tukacustoms/Released-Files-TCBK40/PERMALINK LAYOUT.txt

http://www.keyboard-layout-editor.com/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

http://builder.swillkb.com/
