tukacustoms/Released-Files-TCBK40/BOM Files TCBK40 - BOM Files TCBK40.csv.csv

Source: | D:\Tuka-Customs-Keyboards\TCBK40\Custom new keyb.kicad_sch
Date: | 7/11/2024 19:20:24
Tool: | Eeschema (6.0.6)
Generator: | E:\Ki Cad PCB\6.0\bin\scripting\plugins/bom_csv_grouped_by_value.py
Component Count: | 122
Individual Components:
Item | Qty | Reference(s) | Value | LibPart | Footprint | Datasheet
 |  | D1 | 1N4148 | Diode:1N4148 | Diode_THT:D_DO-35_SOD27_P7.62mm_Horizontal | https://assets.nexperia.com/documents/data-sheet/1N4148_1N4448.pdf
 |  | D2 | 1N4148 | Diode:1N4148 | Diode_THT:D_DO-35_SOD27_P7.62mm_Horizontal | https://assets.nexperia.com/documents/data-sheet/1N4148_1N4448.pdf
 |  | D3 | 1N4148 | Diode:1N4148 | Diode_THT:D_DO-35_SOD27_P7.62mm_Horizontal | https://assets.nexperia.com/documents/data-sheet/1N4148_1N4448.pdf
 |  | D4 | 1N4148 | Diode:1N4148 | Diode_THT:D_DO-35_SOD27_P7.62mm_Horizontal | https://assets.nexperia.com/documents/data-sheet/1N4148_1N4448.pdf
 |  | D5 | 1N4148 | Diode:1N4148 | Diode_THT:D_DO-35_SOD27_P7.62mm_Horizontal | https://assets.nexperia.com/documents/data-sheet/1N4148_1N4448.pdf
 |  | D6 | 1N4148 | Diode:1N4148 | Diode_THT:D_DO-35_SOD27_P7.62mm_Horizontal | https://assets.nexperia.com/documents/data-sheet/1N4148_1N4448.pdf
 |  | D7 | 1N4148 | Diode:1N4148 | Diode_THT:D_DO-35_SOD27_P7.62mm_Horizontal | https://assets.nexperia.com/documents/data-sheet/1N4148_1N4448.pdf
 |  | D8 | 1N4148 | Diode:1N4148 | Diode_THT:D_DO-35_SOD27_P7.62mm_Horizontal | https://assets.nexperia.com/documents/data-sheet/1N4148_1N4448.pdf
 |  | D9 | 1N4148 | Diode:1N4148 | Diode_THT:D_DO-35_SOD27_P7.62mm_Horizontal | https://assets.nexperia.com/documents/data-sheet/1N4148_1N4448.pdf
 |  | D10 | 1N4148 | Diode:1N4148 | Diode_THT:D_DO-35_SOD27_P7.62mm_Horizontal | https://assets.nexperia.com/documents/data-sheet/1N4148_1N4448.pdf
 |  | D11 | 1N4148 | Diode:1N4148 | Diode_THT:D_DO-35_SOD27_P7.62mm_Horizontal | https://assets.nexperia.com/documents/data-sheet/1N4148_1N4448.pdf
 |  | D12 | 1N4148 | Diode:1N4148 | Diode_THT:D_DO-35_SOD27_P7.62mm_Horizontal | https://assets.nexperia.com/documents/data-sheet/1N4148_1N4448.pdf
 |  | D13 | 1N4148 | Diode:1N4148 | Diode_THT:D_DO-35_SOD27_P7.62mm_Horizontal | https://assets.nexperia.com/documents/data-sheet/1N4148_1N4448.pdf
 |  | D14 | 1N4148 | Diode:1N4148 | Diode_THT:D_DO-35_SOD27_P7.62mm_Horizontal | https://assets.nexperia.com/documents/data-sheet/1N4148_1N4448.pdf
 |  | D15 | 1N4148 | Diode:1N4148 | Diode_THT:D_DO-35_SOD27_P7.62mm_Horizontal | https://assets.nexperia.com/documents/data-sheet/1N4148_1N4448.pdf
 |  | D16 | 1N4148 | Diode:1N4148 | Diode_THT:D_DO-35_SOD27_P7.62mm_Horizontal | https://assets.nexperia.com/documents/data-sheet/1N4148_1N4448.pdf
 |  | D17 | 1N4148 | Diode:1N4148 | Diode_THT:D_DO-35_SOD27_P7.62mm_Horizontal | https://assets.nexperia.com/documents/data-sheet/1N4148_1N4448.pdf
 |  | D18 | 1N4148 | Diode:1N4148 | Diode_THT:D_DO-35_SOD27_P7.62mm_Horizontal | https://assets.nexperia.com/documents/data-sheet/1N4148_1N4448.pdf
 |  | D19 | 1N4148 | Diode:1N4148 | Diode_THT:D_DO-35_SOD27_P7.62mm_Horizontal | https://assets.nexperia.com/documents/data-sheet/1N4148_1N4448.pdf
 |  | D20 | 1N4148 | Diode:1N4148 | Diode_THT:D_DO-35_SOD27_P7.62mm_Horizontal | https://assets.nexperia.com/documents/data-sheet/1N4148_1N4448.pdf
 |  | D21 | 1N4148 | Diode:1N4148 | Diode_THT:D_DO-35_SOD27_P7.62mm_Horizontal | https://assets.nexperia.com/documents/data-sheet/1N4148_1N4448.pdf
 |  | D22 | 1N4148 | Diode:1N4148 | Diode_THT:D_DO-35_SOD27_P7.62mm_Horizontal | https://assets.nexperia.com/documents/data-sheet/1N4148_1N4448.pdf
 |  | D23 | 1N4148 | Diode:1N4148 | Diode_THT:D_DO-35_SOD27_P7.62mm_Horizontal | https://assets.nexperia.com/documents/data-sheet/1N4148_1N4448.pdf
 |  | D24 | 1N4148 | Diode:1N4148 | Diode_THT:D_DO-35_SOD27_P7.62mm_Horizontal | https://assets.nexperia.com/documents/data-sheet/1N4148_1N4448.pdf
 |  | D25 | 1N4148 | Diode:1N4148 | Diode_THT:D_DO-35_SOD27_P7.62mm_Horizontal | https://assets.nexperia.com/documents/data-sheet/1N4148_1N4448.pdf
 |  | D26 | 1N4148 | Diode:1N4148 | Diode_THT:D_DO-35_SOD27_P7.62mm_Horizontal | https://assets.nexperia.com/documents/data-sheet/1N4148_1N4448.pdf
 |  | D27 | 1N4148 | Diode:1N4148 | Diode_THT:D_DO-35_SOD27_P7.62mm_Horizontal | https://assets.nexperia.com/documents/data-sheet/1N4148_1N4448.pdf
 |  | D28 | 1N4148 | Diode:1N4148 | Diode_THT:D_DO-35_SOD27_P7.62mm_Horizontal | https://assets.nexperia.com/documents/data-sheet/1N4148_1N4448.pdf
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
 |  | SW3_2 | 1.00u | kobuss:1.00u | kobussfootprints:MX_1u | ~
 |  | SW3_3 | 1.00u | kobuss:1.00u | kobussfootprints:MX_1u | ~
 |  | SW3_4 | 1.00u | kobuss:1.00u | kobussfootprints:MX_1u | ~
 |  | SW3_5 | 1.00u | kobuss:1.00u | kobussfootprints:MX_1u | ~
 |  | SW3_6 | 1.00u | kobuss:1.00u | kobussfootprints:MX_1u | ~
 |  | SW3_7 | 1.00u | kobuss:1.00u | kobussfootprints:MX_1u | ~
 |  | SW3_8 | 1.00u | kobuss:1.00u | kobussfootprints:MX_1u | ~
 |  | SW3_9 | 1.00u | kobuss:1.00u | kobussfootprints:MX_1u | ~
 |  | SW3_10 | 1.25u | kobuss:1.25u | kobussfootprints:MX_1.25 | ~
 |  | SW3_11 | 1.00u | kobuss:1.00u | kobussfootprints:MX_1u | ~
 |  | SW4_1 | 1.00u | kobuss:1.00u | kobussfootprints:MX_1u | ~
 |  | SW4_2 | 1.25u | kobuss:1.25u | kobussfootprints:MX_1.25 | ~
 |  | SW4_3 | 2.25u | kobuss:2.25u | kobussfootprints:MX_2.25u | ~
 |  | SW4_4 | 2.25u | kobuss:2.25u | kobussfootprints:MX_2.25u | ~
 |  | SW4_5 | 1.25u | kobuss:1.25u | kobussfootprints:MX_1.25 | ~
 |  | SW4_6 | 1.00u | kobuss:1.00u | kobussfootprints:MX_1u | ~
 |  | U1 | ProMicro | keebio parts:ProMicro | Keebio-Parts:ArduinoProMicro
Collated Components:
Item | Qty | Reference(s) | Value | LibPart | Footprint | Datasheet
1 | 40 | D1, D2, D3, D4, D5, D6, D7, D8, D9, D10, D11, D12, D13, D14, D15, D16, D17, D18, D19, D20, D21, D22, D23, D24, D25, D26, D27, D28, D29, D30, D31, D32, D33, D34, D35, D36, D37, D38, D39, D40 | 1N4148 | Diode:1N4148 | Diode_THT:D_DO-35_SOD27_P7.62mm_Horizontal | https://assets.nexperia.com/documents/data-sheet/1N4148_1N4448.pdf
2 | 40 | LED1, LED2, LED3, LED5, LED6, LED7, LED9, LED10, LED11, LED13, LED14, LED16, LED18, LED19, LED21, LED23, LED24, LED26, LED28, LED29, LED31, LED33, LED34, LED36, LED38, LED39, LED41, LED43, LED44, LED46, LED48, LED49, LED51, LED53, LED54, LED55, LED57, LED58, LED60, LED61 | SK6812MINI-E | marbastlib-various:SK6812MINI-E | marbastlib-various:LED_6028R
3 | 1 | R1 | 360 | Device:R | Resistor_SMD:R_0805_2012Metric | ~
4 | 32 | SW1_1, SW1_2, SW1_3, SW1_4, SW1_5, SW1_6, SW1_7, SW1_8, SW1_9, SW1_10, SW1_11, SW1_12, SW2_2, SW2_3, SW2_4, SW2_5, SW2_6, SW2_7, SW2_8, SW2_9, SW2_10, SW3_2, SW3_3, SW3_4, SW3_5, SW3_6, SW3_7, SW3_8, SW3_9, SW3_11, SW4_1, SW4_6 | 1.00u | kobuss:1.00u | kobussfootprints:MX_1u | ~
5 | 4 | SW2_1, SW3_10, SW4_2, SW4_5 | 1.25u | kobuss:1.25u | kobussfootprints:MX_1.25 | ~
6 | 2 | SW2_11, SW3_1 | 1.75u_stepped_caps_lock | kobuss:1.75u_stepped_caps_lock | kobussfootprints:MX_1.75u | ~
7 | 2 | SW4_3, SW4_4 | 2.25u | kobuss:2.25u | kobussfootprints:MX_2.25u | ~
8 | 1 | U1 | ProMicro | keebio parts:ProMicro | Keebio-Parts:ArduinoProMicro
External Components:
Item | Qty | Reference(s) | Link | Brand | Specifications | Optional
Switches | 40 | AL SW | https://pt.aliexpress.com/item/1005005374016411.html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 | MMMD Princess | Linear 38g V2 | Tactile 48g V2
Keycaps | 40 pcs | All SW | https://pt.aliexpress.com/item/1005006655619138.html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 | XDA SET | Korean, By box | https://pt.aliexpress.com/item/1005005892669410.html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 | Black Coral MOA SET
Stabilizers | 1 Kit - 3 pcs | SW2_11, SW3_1 | https://pt.aliexpress.com/item/1005006753850845.html?scm_id=1007.40050.354490.0&scm-url=1007.40050.354490.0 | TX KEYBOARD PCB | Green Long Pole3x2U
Pro Micro | 1 | U1 | https://pt.aliexpress.com/item/32846843498.html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 | ATMEga32U4 | Type-C Cable
Sandoffs | 8 |  | https://pt.aliexpress.com/item/33056920439.html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 | Light Blue color | M3x15
Case | 1 |  | https://pt.aliexpress.com/item/1005005922943680.html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 | PU felt Bag | 40%
