tukacustoms/Released-Files-TCBK40/Custom new keyb.kicad_sch

## KiCad design Custom new keyb.kicad_sch (2026-05-11)

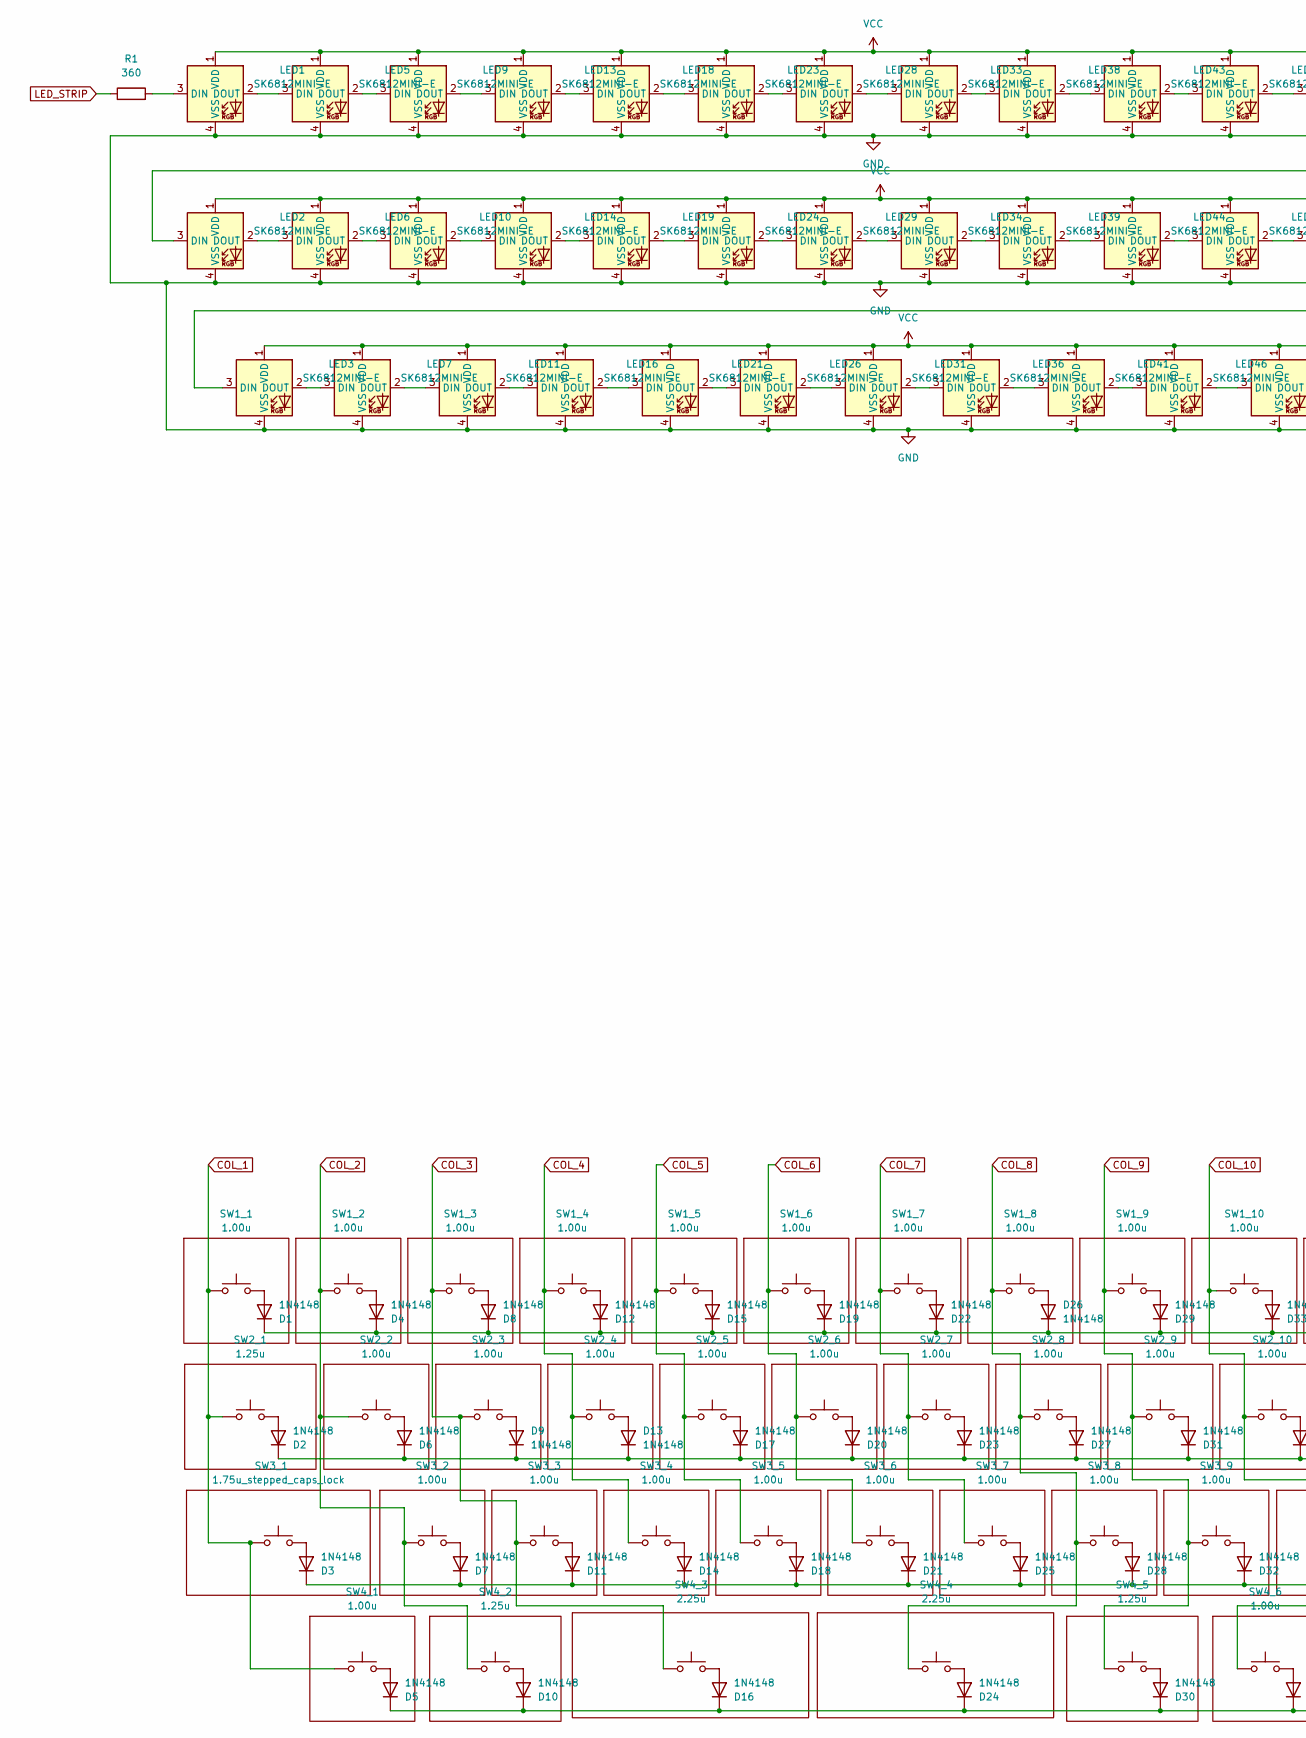
[picture p1: schematic Custom new keyb.kicad_sch, part in row 1, column 1]

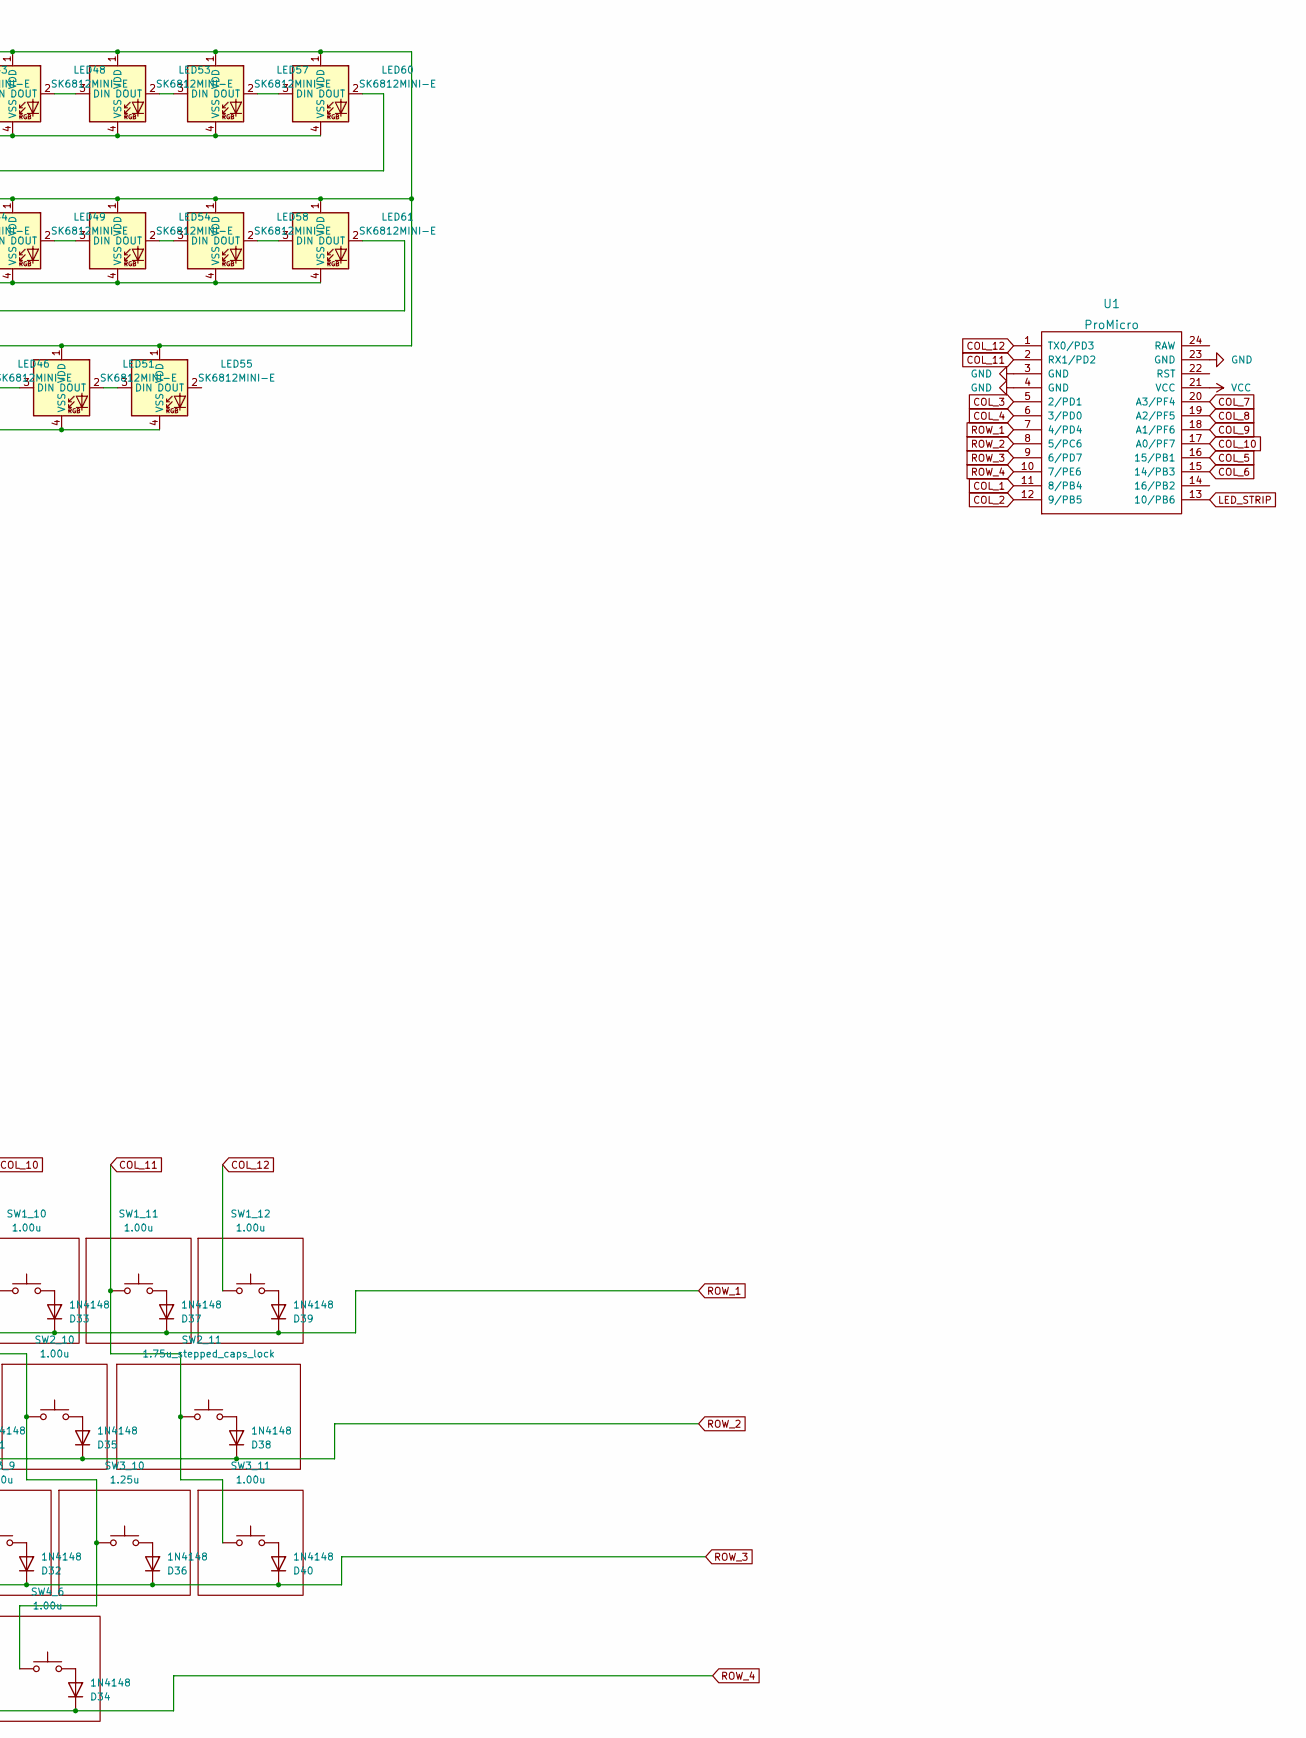
[picture p2: schematic Custom new keyb.kicad_sch, part in row 1, column 2]

Parts:
D1, D2, D3, D4, D5, D6, D7, D8, D9, D10, D11, D12, D13, D14, D15, D16, D17, D18, D19, D20, D21, D22, D23, D24, D25, D26, D27, D28, D29, D30, D31, D32, D33, D34, D35, D36, D37, D38, D39, D40: 1N4148; D_DO-35_SOD27_P7.62mm_Horizontal
LED1, LED2, LED3, LED5, LED6, LED7, LED9, LED10, LED11, LED13, LED14, LED16, LED18, LED19, LED21, LED23, LED24, LED26, LED28, LED29, LED31, LED33, LED34, LED36, LED38, LED39, LED41, LED43, LED44, LED46, LED48, LED49, LED51, LED53, LED54, LED55, LED57, LED58, LED60, LED61: SK6812MINI-E; LED_6028R
R1: 360; R_0805_2012Metric
SW1_1, SW1_2, SW1_3, SW1_4, SW1_5, SW1_6, SW1_7, SW1_8, SW1_9, SW1_10, SW1_11, SW1_12, SW2_2, SW2_3, SW2_4, SW2_5, SW2_6, SW2_7, SW2_8, SW2_9, SW2_10, SW3_2, SW3_3, SW3_4, SW3_5, SW3_6, SW3_7, SW3_8, SW3_9, SW3_11, SW4_1, SW4_6: 1.00u; MX_1u
SW2_1, SW3_10, SW4_2, SW4_5: 1.25u; MX_1.25
SW2_11, SW3_1: 1.75u_stepped_caps_lock; MX_1.75u
SW4_3, SW4_4: 2.25u; MX_2.25u
U1: ProMicro; ArduinoProMicro

Connections:
COL_1: SW1_1.1, SW2_1.1, SW3_1.1, SW4_1.1, U1.11 (8/PB4)
COL_2: SW1_2.1, SW2_2.1, SW3_2.1, SW4_2.1, U1.12 (9/PB5)
COL_3: SW1_3.1, SW2_3.1, SW3_3.1, SW4_3.1, U1.5 (2/PD1)
COL_4: SW1_4.1, SW2_4.1, SW3_4.1, U1.6 (3/PD0)
COL_5: SW1_5.1, SW2_5.1, SW3_5.1, U1.16 (15/PB1)
COL_6: SW1_6.1, SW2_6.1, SW3_6.1, U1.15 (14/PB3)
COL_7: SW1_7.1, SW2_7.1, SW3_7.1, U1.20 (A3/PF4)
COL_8: SW1_8.1, SW2_8.1, SW3_8.1, SW4_4.1, U1.19 (A2/PF5)
COL_9: SW1_9.1, SW2_9.1, SW3_9.1, SW4_5.1, U1.18 (A1/PF6)
COL_10: SW1_10.1, SW2_10.1, SW3_10.1, SW4_6.1, U1.17 (A0/PF7)
COL_11: SW1_11.1, SW2_11.1, SW3_11.1, U1.2 (RX1/PD2)
COL_12: SW1_12.1, U1.1 (TX0/PD3)
GND: LED1.4 (VSS), LED2.4 (VSS), LED3.4 (VSS), LED5.4 (VSS), LED6.4 (VSS), LED7.4 (VSS), LED9.4 (VSS), LED10.4 (VSS), LED11.4 (VSS), LED13.4 (VSS), LED14.4 (VSS), LED16.4 (VSS), LED18.4 (VSS), LED19.4 (VSS), LED21.4 (VSS), LED23.4 (VSS), LED24.4 (VSS), LED26.4 (VSS), LED28.4 (VSS), LED29.4 (VSS), LED31.4 (VSS), LED33.4 (VSS), LED34.4 (VSS), LED36.4 (VSS), LED38.4 (VSS), LED39.4 (VSS), LED41.4 (VSS), LED43.4 (VSS), LED44.4 (VSS), LED46.4 (VSS), LED48.4 (VSS), LED49.4 (VSS), LED51.4 (VSS), LED53.4 (VSS), LED54.4 (VSS), LED55.4 (VSS), LED57.4 (VSS), LED58.4 (VSS), LED60.4 (VSS), LED61.4 (VSS), U1.3 (GND), U1.4 (GND), U1.23 (GND)
LED_STRIP: R1.1, U1.13 (10/PB6)
unnamed: D1.2 (A), SW1_1.2
unnamed: D2.2 (A), SW2_1.2
unnamed: D3.2 (A), SW3_1.2
unnamed: D4.2 (A), SW1_2.2
unnamed: D5.2 (A), SW4_1.2
unnamed: D6.2 (A), SW2_2.2
unnamed: D7.2 (A), SW3_2.2
unnamed: D8.2 (A), SW1_3.2
unnamed: D9.2 (A), SW2_3.2
unnamed: D10.2 (A), SW4_2.2
unnamed: D11.2 (A), SW3_3.2
unnamed: D12.2 (A), SW1_4.2
unnamed: D13.2 (A), SW2_4.2
unnamed: D14.2 (A), SW3_4.2
unnamed: D15.2 (A), SW1_5.2
unnamed: D16.2 (A), SW4_3.2
unnamed: D17.2 (A), SW2_5.2
unnamed: D18.2 (A), SW3_5.2
unnamed: D19.2 (A), SW1_6.2
unnamed: D20.2 (A), SW2_6.2
unnamed: D21.2 (A), SW3_6.2
unnamed: D22.2 (A), SW1_7.2
unnamed: D23.2 (A), SW2_7.2
unnamed: D24.2 (A), SW4_4.2
unnamed: D25.2 (A), SW3_7.2
unnamed: D26.2 (A), SW1_8.2
unnamed: D27.2 (A), SW2_8.2
unnamed: D28.2 (A), SW3_8.2
unnamed: D29.2 (A), SW1_9.2
unnamed: D30.2 (A), SW4_5.2
unnamed: D31.2 (A), SW2_9.2
unnamed: D32.2 (A), SW3_9.2
unnamed: D33.2 (A), SW1_10.2
unnamed: D34.2 (A), SW4_6.2
unnamed: D35.2 (A), SW2_10.2
unnamed: D36.2 (A), SW3_10.2
unnamed: D37.2 (A), SW1_11.2
unnamed: D38.2 (A), SW2_11.2
unnamed: D39.2 (A), SW1_12.2
unnamed: D40.2 (A), SW3_11.2
unnamed: LED1.2 (DOUT), LED5.3 (DIN)
unnamed: LED1.3 (DIN), R1.2
unnamed: LED2.2 (DOUT), LED6.3 (DIN)
unnamed: LED2.3 (DIN), LED60.2 (DOUT)
unnamed: LED3.2 (DOUT), LED7.3 (DIN)
unnamed: LED3.3 (DIN), LED61.2 (DOUT)
unnamed: LED5.2 (DOUT), LED9.3 (DIN)
unnamed: LED10.2 (DOUT), LED14.3 (DIN)
unnamed: LED6.2 (DOUT), LED10.3 (DIN)
unnamed: LED11.2 (DOUT), LED16.3 (DIN)
unnamed: LED7.2 (DOUT), LED11.3 (DIN)
unnamed: LED13.2 (DOUT), LED18.3 (DIN)
unnamed: LED9.2 (DOUT), LED13.3 (DIN)
unnamed: LED14.2 (DOUT), LED19.3 (DIN)
unnamed: LED16.2 (DOUT), LED21.3 (DIN)
unnamed: LED18.2 (DOUT), LED23.3 (DIN)
unnamed: LED19.2 (DOUT), LED24.3 (DIN)
unnamed: LED21.2 (DOUT), LED26.3 (DIN)
unnamed: LED23.2 (DOUT), LED28.3 (DIN)
unnamed: LED24.2 (DOUT), LED29.3 (DIN)
unnamed: LED26.2 (DOUT), LED31.3 (DIN)
unnamed: LED28.2 (DOUT), LED33.3 (DIN)
unnamed: LED29.2 (DOUT), LED34.3 (DIN)
unnamed: LED31.2 (DOUT), LED36.3 (DIN)
unnamed: LED33.2 (DOUT), LED38.3 (DIN)
unnamed: LED34.2 (DOUT), LED39.3 (DIN)
unnamed: LED36.2 (DOUT), LED41.3 (DIN)
unnamed: LED38.2 (DOUT), LED43.3 (DIN)
unnamed: LED39.2 (DOUT), LED44.3 (DIN)
unnamed: LED41.2 (DOUT), LED46.3 (DIN)
unnamed: LED43.2 (DOUT), LED48.3 (DIN)
unnamed: LED44.2 (DOUT), LED49.3 (DIN)
unnamed: LED46.2 (DOUT), LED51.3 (DIN)
unnamed: LED48.2 (DOUT), LED53.3 (DIN)
unnamed: LED49.2 (DOUT), LED54.3 (DIN)
unnamed: LED51.2 (DOUT), LED55.3 (DIN)
unnamed: LED53.2 (DOUT), LED57.3 (DIN)
unnamed: LED54.2 (DOUT), LED58.3 (DIN)
unnamed: LED57.2 (DOUT), LED60.3 (DIN)
unnamed: LED58.2 (DOUT), LED61.3 (DIN)
ROW_1: D1.1 (K), D4.1 (K), D8.1 (K), D12.1 (K), D15.1 (K), D19.1 (K), D22.1 (K), D26.1 (K), D29.1 (K), D33.1 (K), D37.1 (K), D39.1 (K), U1.7 (4/PD4)
ROW_2: D2.1 (K), D6.1 (K), D9.1 (K), D13.1 (K), D17.1 (K), D20.1 (K), D23.1 (K), D27.1 (K), D31.1 (K), D35.1 (K), D38.1 (K), U1.8 (5/PC6)
ROW_3: D3.1 (K), D7.1 (K), D11.1 (K), D14.1 (K), D18.1 (K), D21.1 (K), D25.1 (K), D28.1 (K), D32.1 (K), D36.1 (K), D40.1 (K), U1.9 (6/PD7)
ROW_4: D5.1 (K), D10.1 (K), D16.1 (K), D24.1 (K), D30.1 (K), D34.1 (K), U1.10 (7/PE6)
VCC: LED1.1 (VDD), LED2.1 (VDD), LED3.1 (VDD), LED5.1 (VDD), LED6.1 (VDD), LED7.1 (VDD), LED9.1 (VDD), LED10.1 (VDD), LED11.1 (VDD), LED13.1 (VDD), LED14.1 (VDD), LED16.1 (VDD), LED18.1 (VDD), LED19.1 (VDD), LED21.1 (VDD), LED23.1 (VDD), LED24.1 (VDD), LED26.1 (VDD), LED28.1 (VDD), LED29.1 (VDD), LED31.1 (VDD), LED33.1 (VDD), LED34.1 (VDD), LED36.1 (VDD), LED38.1 (VDD), LED39.1 (VDD), LED41.1 (VDD), LED43.1 (VDD), LED44.1 (VDD), LED46.1 (VDD), LED48.1 (VDD), LED49.1 (VDD), LED51.1 (VDD), LED53.1 (VDD), LED54.1 (VDD), LED55.1 (VDD), LED57.1 (VDD), LED58.1 (VDD), LED60.1 (VDD), LED61.1 (VDD), U1.21 (VCC)
