tukacustoms/Released-Files-TCBK40/(commit log)

2023-01-24 Schematics work
2025-12-03 The TCC Complete Project details
    Thank you Leticia Gadelha Braga for all this dreams becoming true. You always made me de me a better person in life. This is dedicated for you.
2026-05-11 Manufacturing Files
    [BOM Files TCBK40 - BOM Files TCBK40.csv.csv, BOM Files TCBK40.csv, Custom new keyb.kicad_sch]
